johnfertitta/655/case/dxf/bottom.dxf

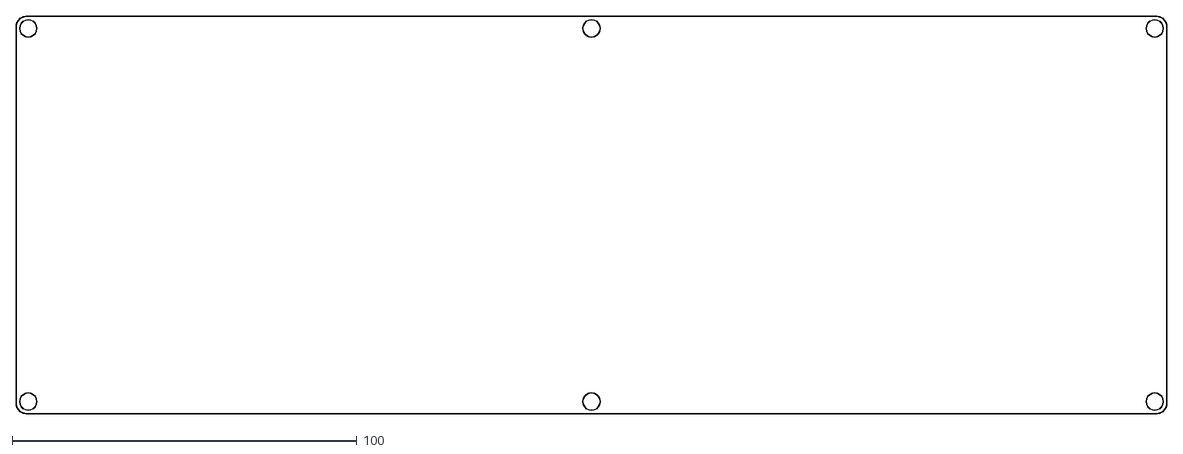
[picture p1: CAD file, 2016-08-23]
case/dxf/bottom.dxf
333.9 x 115.3
