johnfertitta/655/Test board/Plate files/plate.dxf

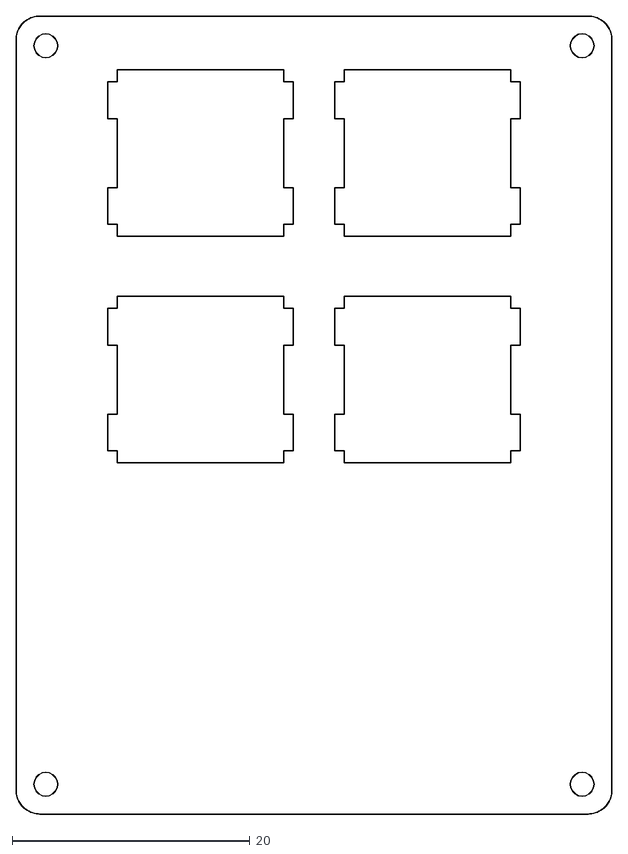
[picture p2: CAD file, 2016-08-31]
Test board/Plate files/plate.dxf
50.1 x 67.1
