johnfertitta/655/case/dxf/closed.dxf

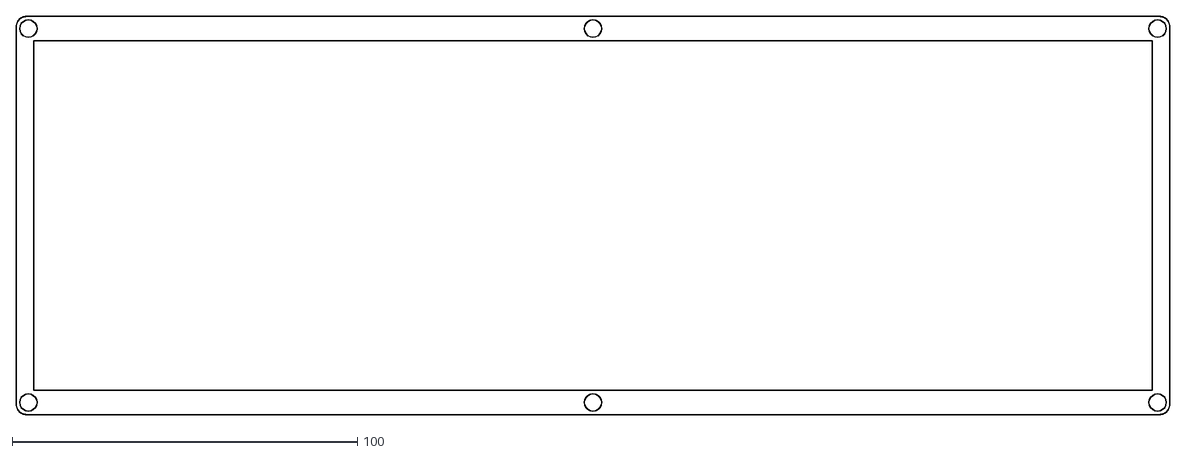
[picture p3: CAD file, 2016-08-23]
case/dxf/closed.dxf
333.9 x 115.3
