johnfertitta/655/Test board/Plate files/layout_guide.dxf

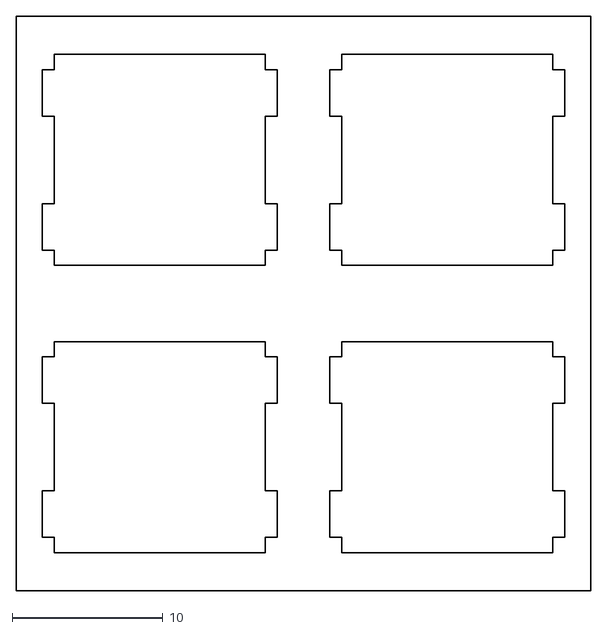
[picture p4: CAD file, 2016-08-31]
Test board/Plate files/layout_guide.dxf
38.1 x 38.1
