johnfertitta/655/case/dxf/switch.dxf

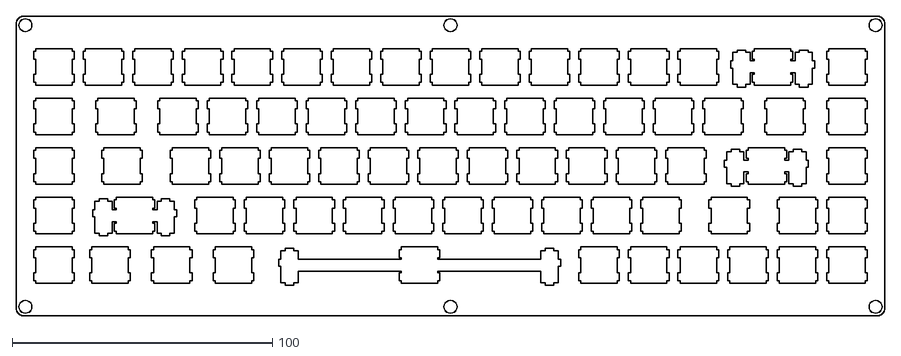
[picture p5: CAD file, 2016-08-23]
case/dxf/switch.dxf
333.9 x 115.3
