johnfertitta/655/case/dxf/open.dxf

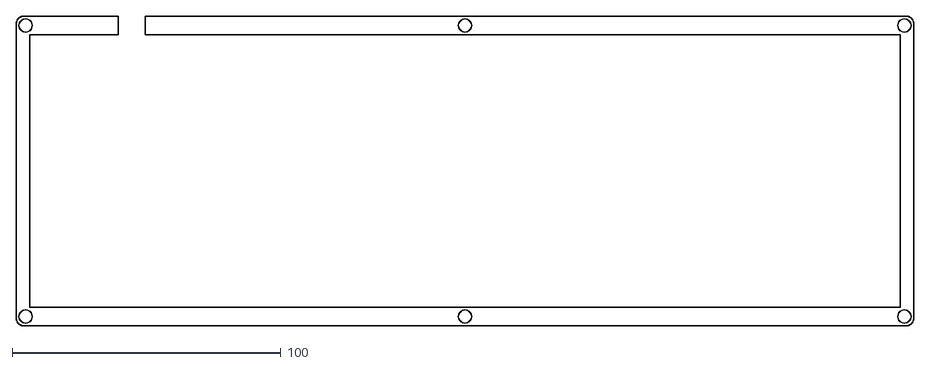
[picture p6: CAD file, 2016-08-23]
case/dxf/open.dxf
333.9 x 115.3
