johnfertitta/655/Test board/gerber-pdf/testboard-B.Mask.pdf

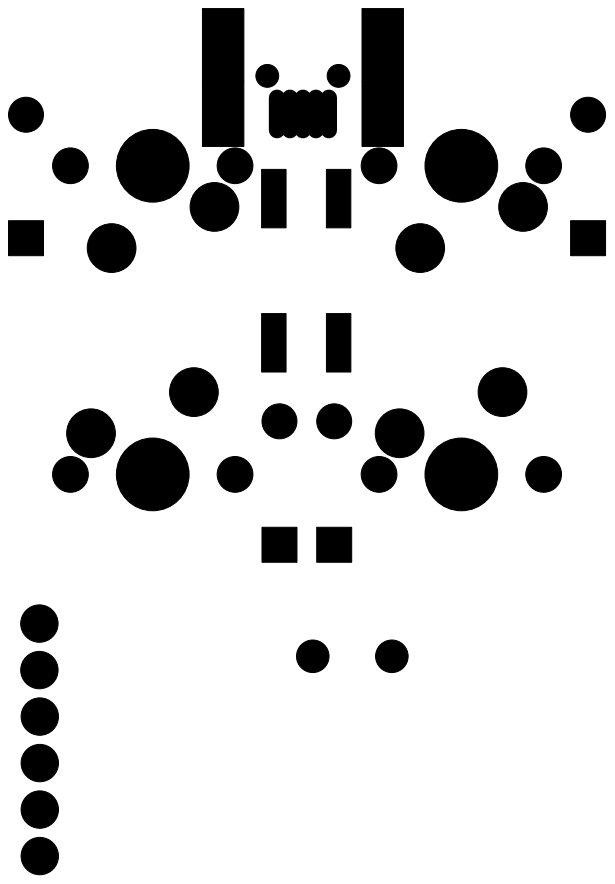
[picture p7: page 1]
