johnfertitta/655/Test board/gerber-pdf/testboard-B.SilkS.pdf

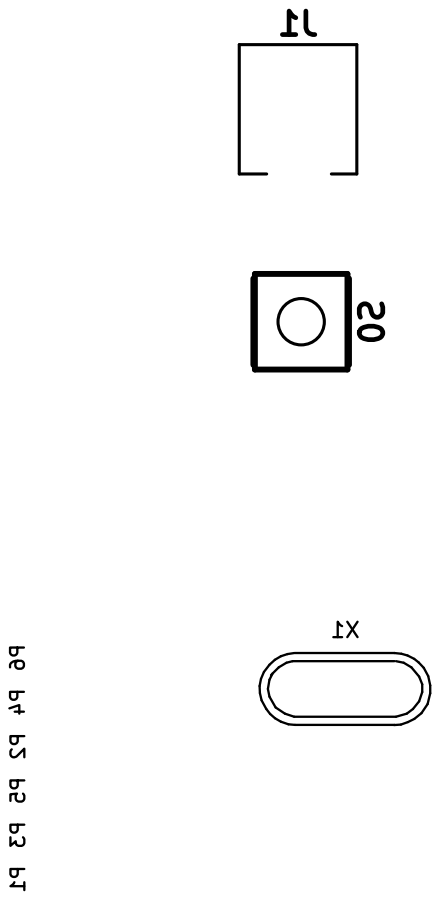
[picture p8: page 1]
