johnfertitta/655/Test board/gerber-pdf/testboard-Back.pdf

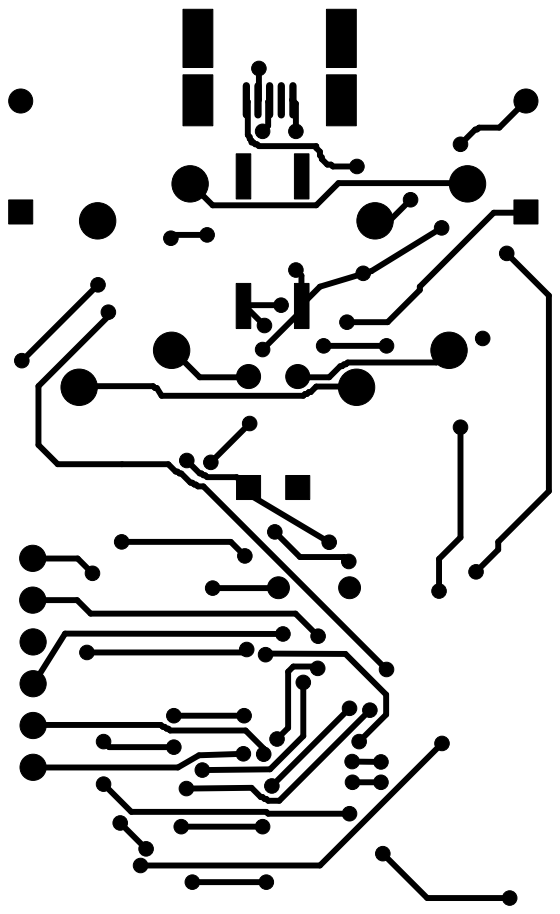
[picture p9: page 1]
