johnfertitta/655/Test board/gerber-pdf/testboard-Eco2.User.pdf

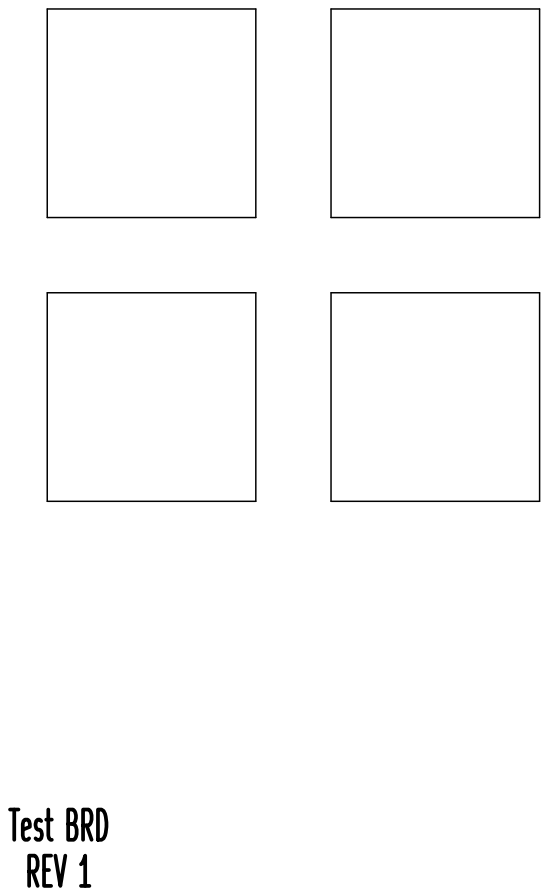
[picture p10: page 1]
