johnfertitta/655/Test board/gerber-pdf/testboard-F.Mask.pdf

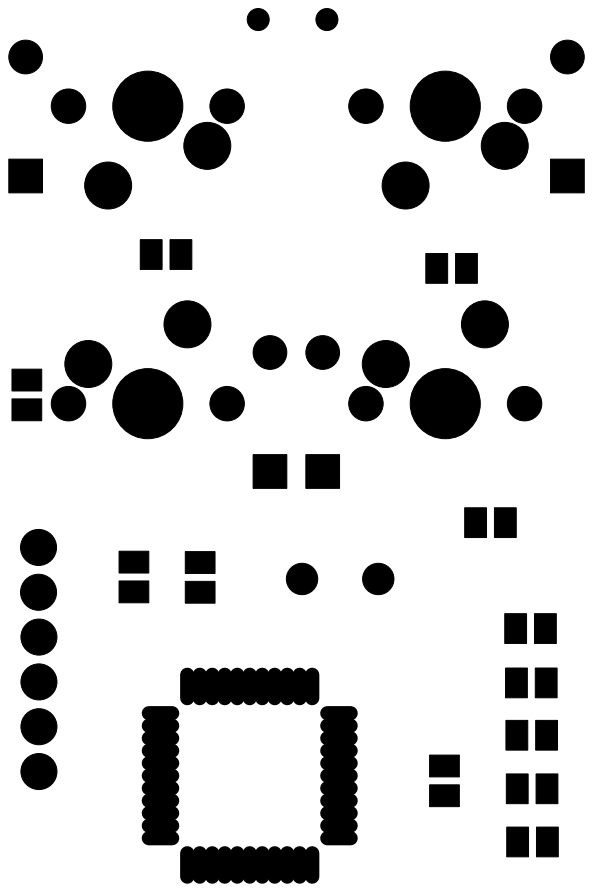
[picture p11: page 1]
