johnfertitta/655/Test board/gerber-pdf/testboard-F.SilkS.pdf

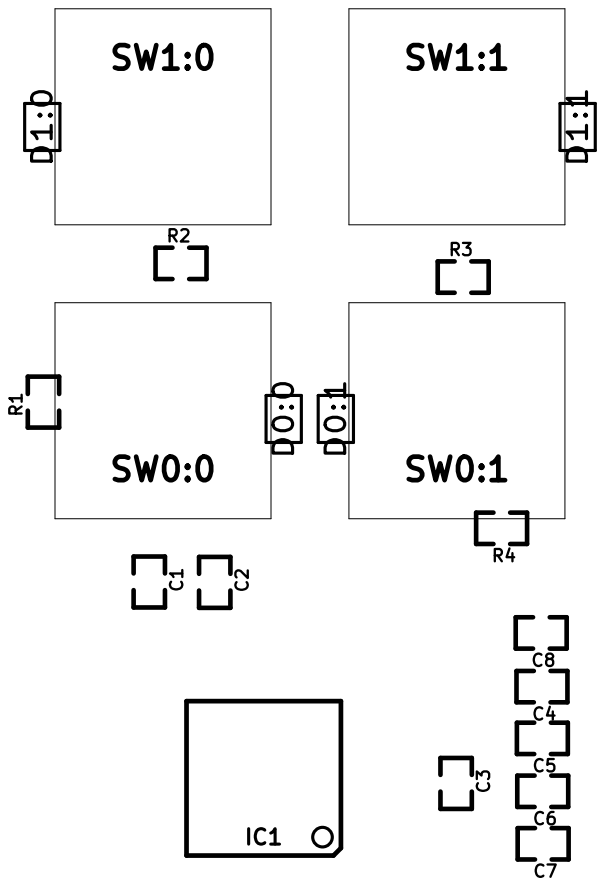
[picture p12: page 1]
