johnfertitta/655/Test board/gerber-pdf/testboard-Front.pdf

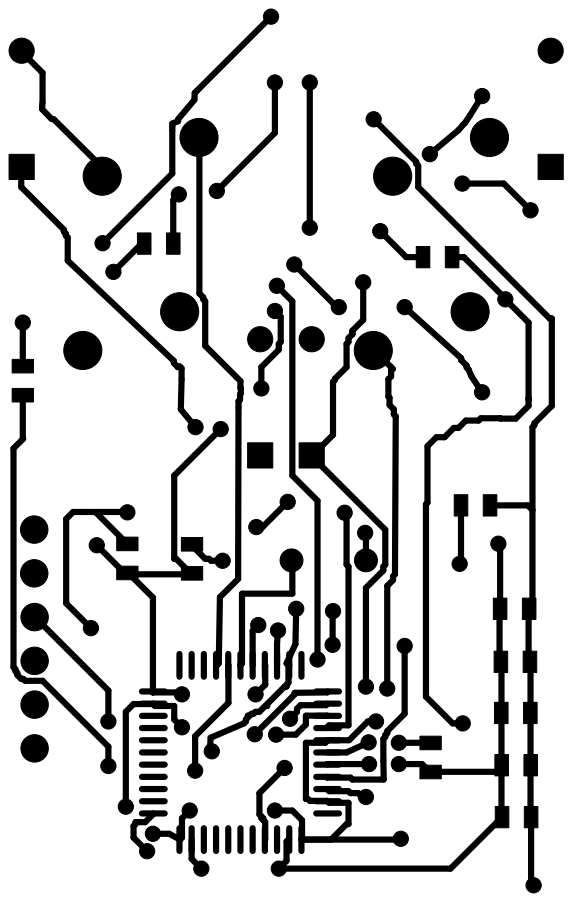
[picture p13: page 1]
