johnfertitta/655/655-Kicad/gerber-pdf/655-B.Mask.pdf

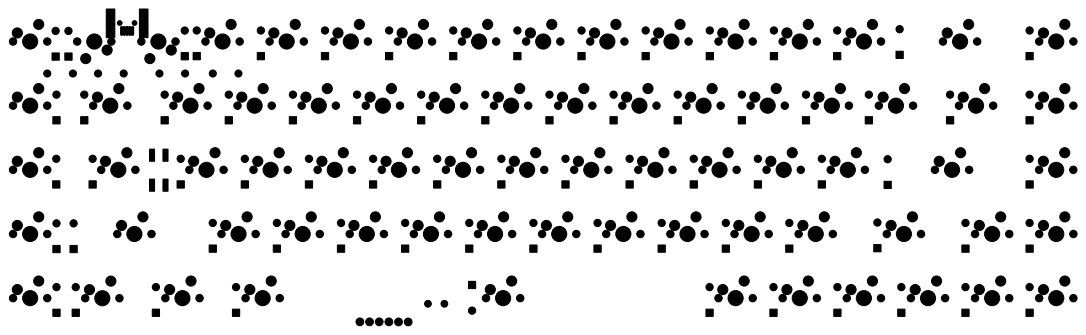
[picture p14: page 1]
