johnfertitta/655/655-Kicad/gerber-pdf/655-B.SilkS.pdf

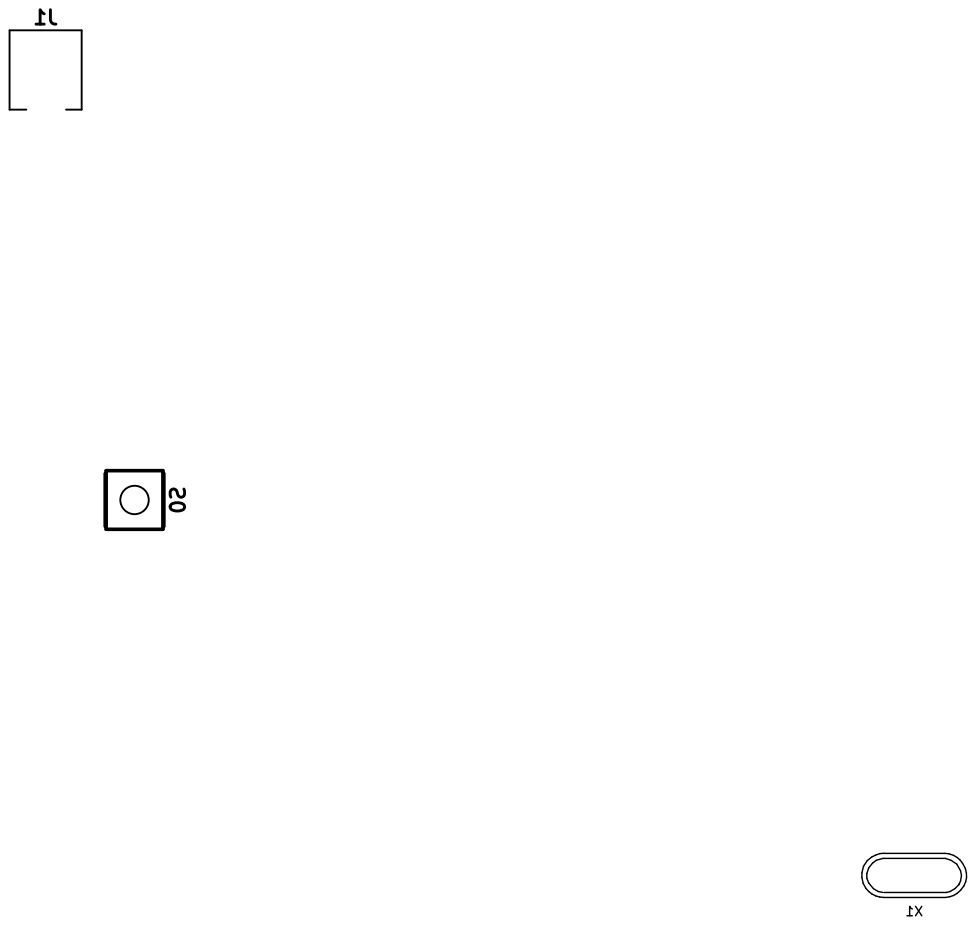
[picture p15: page 1]
