johnfertitta/655/655-Kicad/gerber-pdf/655-Back.pdf

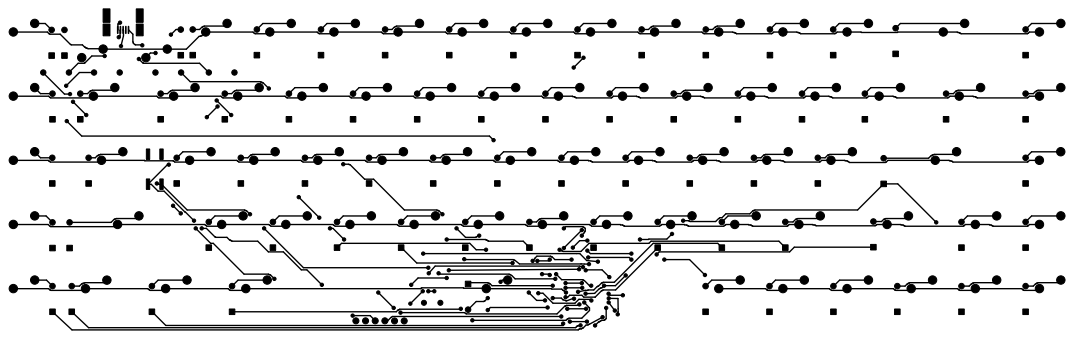
[picture p16: page 1]
