johnfertitta/655/655-Kicad/gerber-pdf/655-Eco2.User.pdf

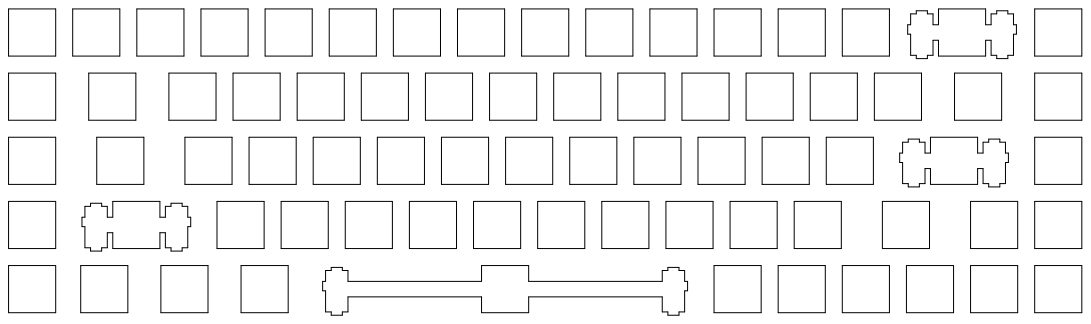
[picture p17: page 1]
