johnfertitta/655/655-Kicad/gerber-pdf/655-F.Mask.pdf

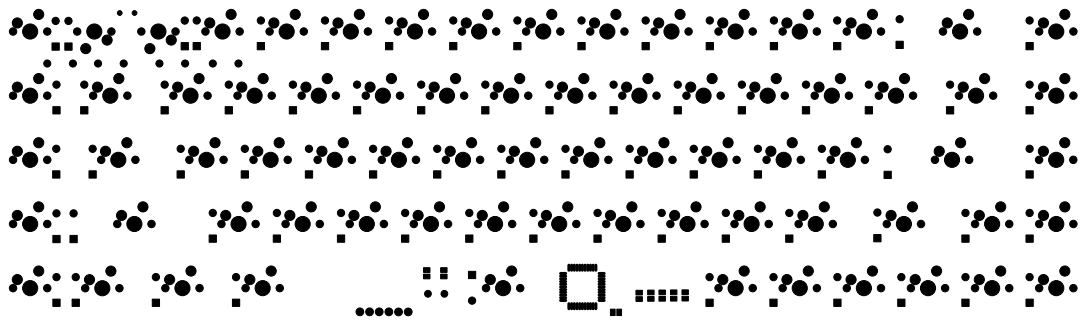
[picture p18: page 1]
