johnfertitta/655/655-Kicad/gerber-pdf/655-F.SilkS.pdf

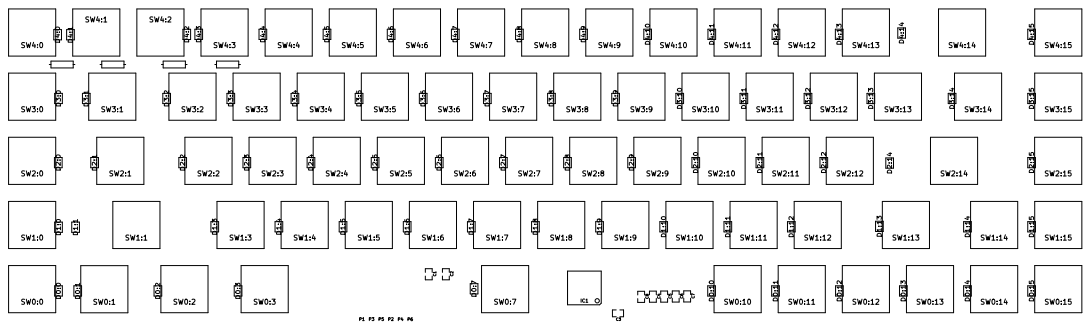
[picture p19: page 1]
