johnfertitta/655/655-Kicad/gerber-pdf/655-Front.pdf

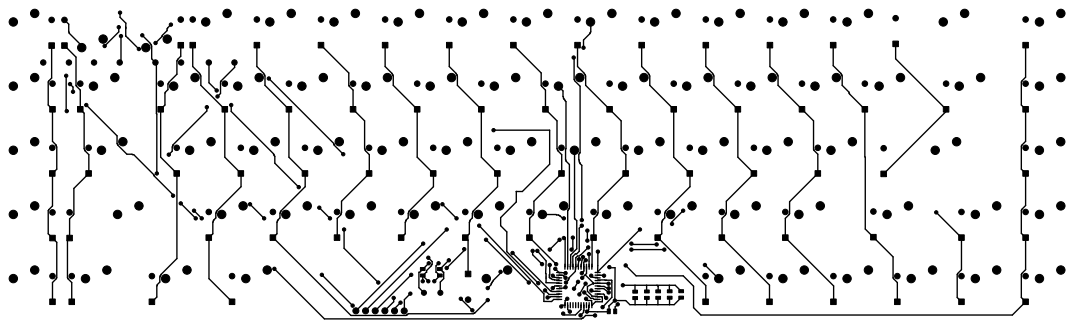
[picture p20: page 1]
