johnfertitta/655/Test board/testboard.kicad_pcb

## KiCad design Test board/testboard.kicad_pcb (2016-08-31)

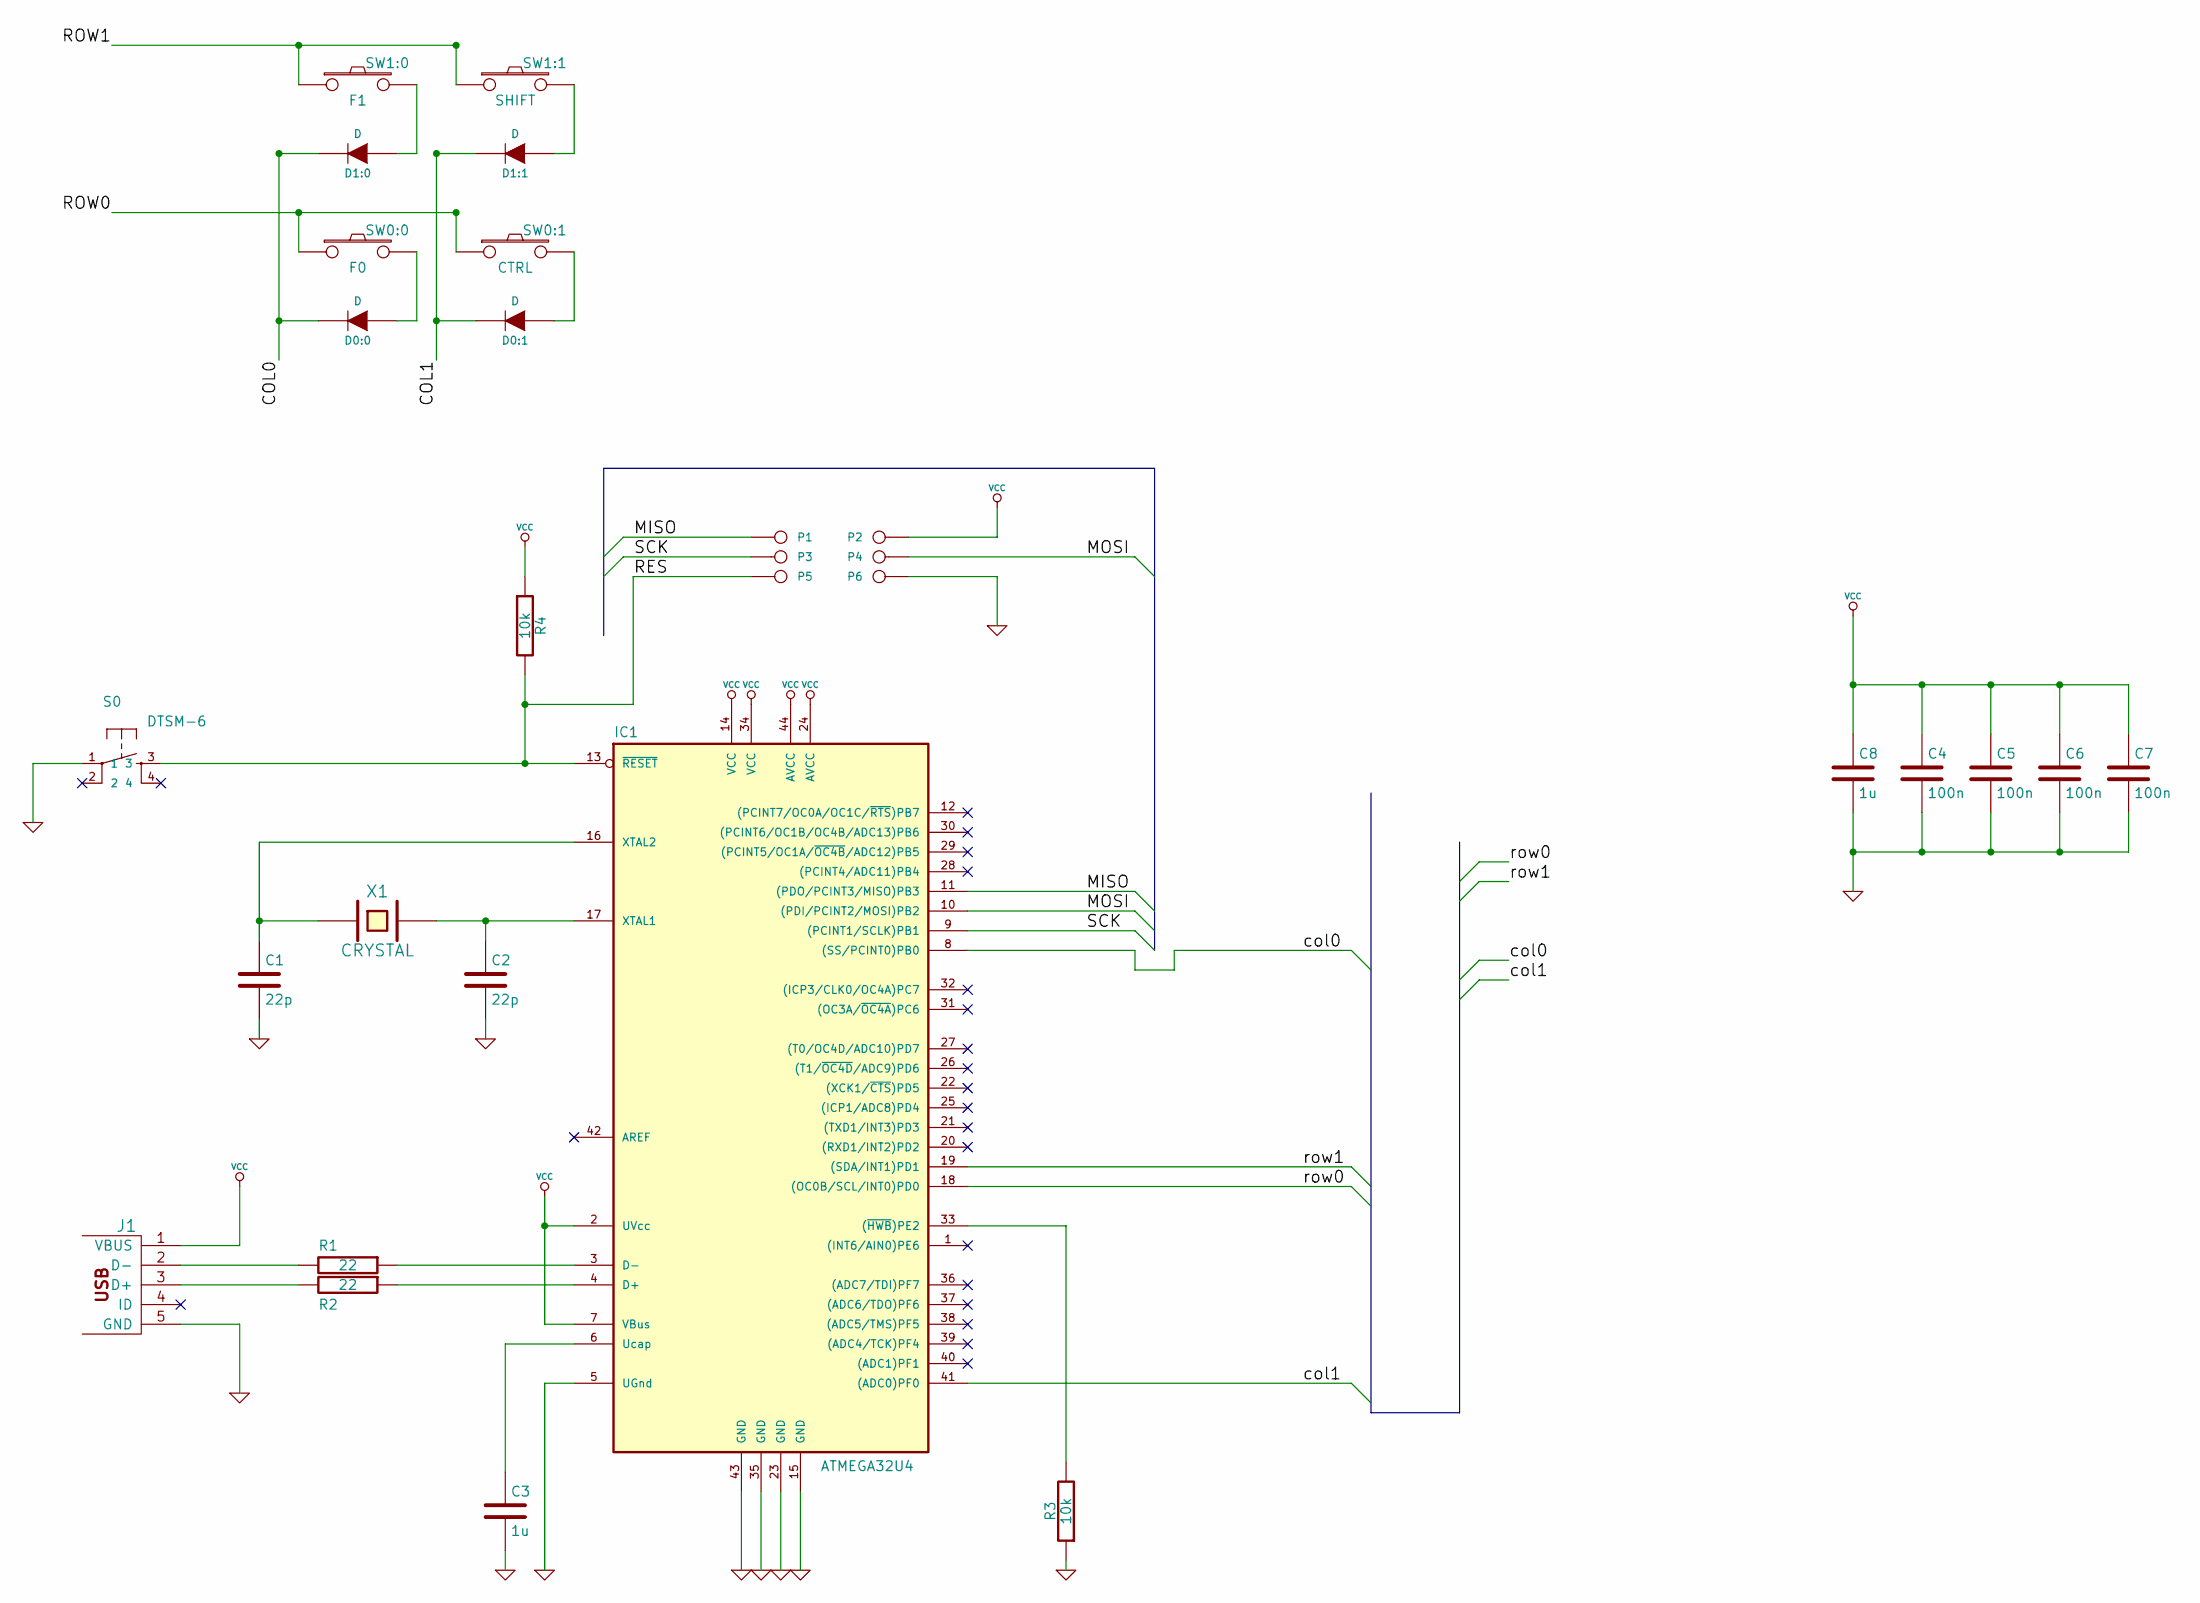
[picture p21: schematic testboard.sch]

Parts:
C1, C2: 22p; 0805C
C3, C8: 1u; 0805C
C4, C5, C6, C7: 100n; 0805C
D0:0, D0:1, D1:0, D1:1: D; DIODE
IC1: ATMEGA32U4; TQFP44
J1: USBMINI_B05; 67503
P1, P2, P3, P4, P5, P6: CONN_1; pad
R1, R2: 22; 0805R
R3, R4: 10k; 0805R
S0: DTSM-6; KSEM31GLFS
SW0:0: F0; MX1A
SW0:1: CTRL; MX1A
SW1:0: F1; MX1A
SW1:1: SHIFT; MX1A
X1: CRYSTAL; Crystal_HC49-U_Vertical

Connections:
/COL0: D0:0.2 (K), D1:0.2 (K), IC1.8 ((SS/PCINT0)PB0)
/COL1: D0:1.2 (K), D1:1.2 (K), IC1.41 ((ADC0)PF0)
/MISO: IC1.11 ((PDO/PCINT3/MISO)PB3), P1.1
/MOSI: IC1.10 ((PDI/PCINT2/MOSI)PB2), P4.1
/RES: IC1.13 (~RESET~), P5.1, R4.2, S0.3
/ROW0: IC1.18 ((OC0B/SCL/INT0)PD0), SW0:0.1, SW0:1.1
/ROW1: IC1.19 ((SDA/INT1)PD1), SW1:0.1, SW1:1.1
/SCK: IC1.9 ((PCINT1/SCLK)PB1), P3.1
GND: C1.2, C2.2, C3.2, C4.2, C5.2, C6.2, C7.2, C8.2, IC1.5 (UGnd), IC1.15 (GND), IC1.23 (GND), IC1.35 (GND), IC1.43 (GND), J1.5 (GND), P6.1, R3.1, S0.1
unnamed: C1.1, IC1.16 (XTAL2), X1.1
unnamed: C2.1, IC1.17 (XTAL1), X1.2
unnamed: C3.1, IC1.6 (Ucap)
unnamed: D0:0.1 (A), SW0:0.2
unnamed: D0:1.1 (A), SW0:1.2
unnamed: D1:0.1 (A), SW1:0.2
unnamed: D1:1.1 (A), SW1:1.2
unnamed: IC1.3 (D-), R1.1
unnamed: IC1.4 (D+), R2.1
unnamed: IC1.33 ((~HWB~)PE2), R3.2
unnamed: J1.2 (D-), R1.2
unnamed: J1.3 (D+), R2.2
VCC: C4.1, C5.1, C6.1, C7.1, C8.1, IC1.2 (UVcc), IC1.7 (VBus), IC1.14 (VCC), IC1.24 (AVCC), IC1.34 (VCC), IC1.44 (AVCC), J1.1 (VBUS), P2.1, R4.1

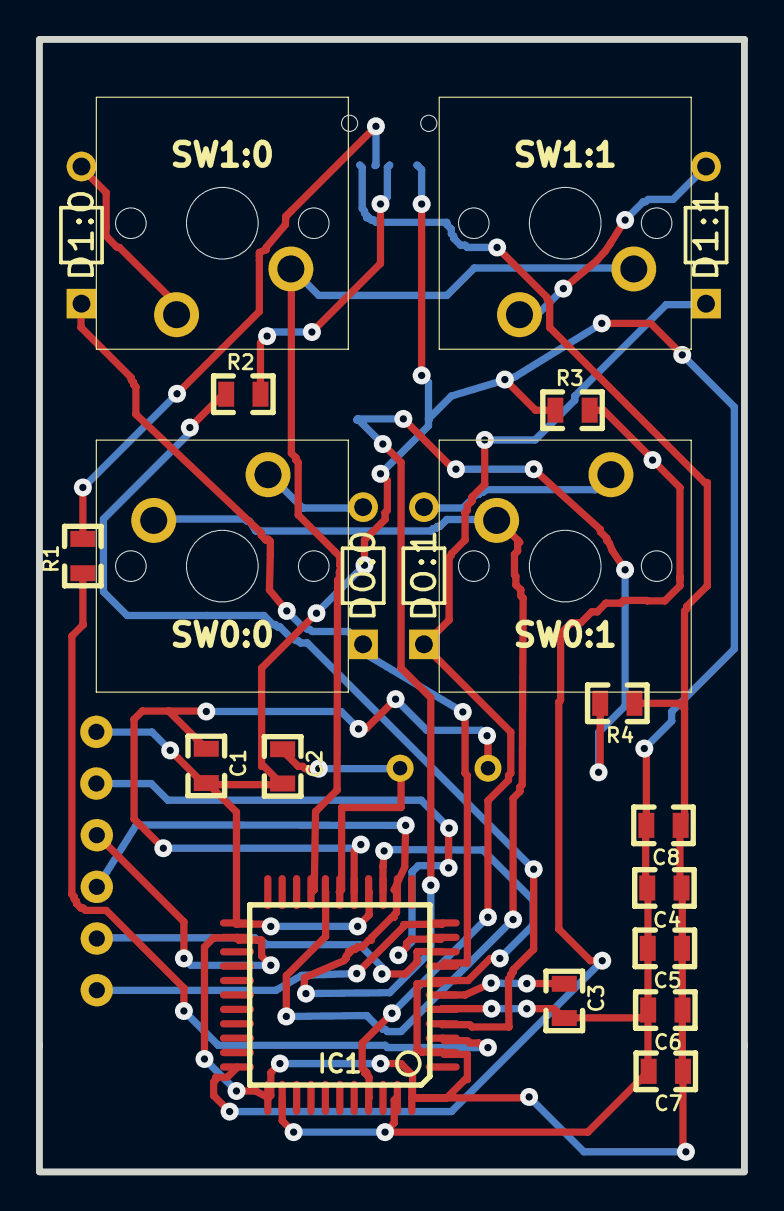
[picture p22: board testboard.kicad_pcb from above]

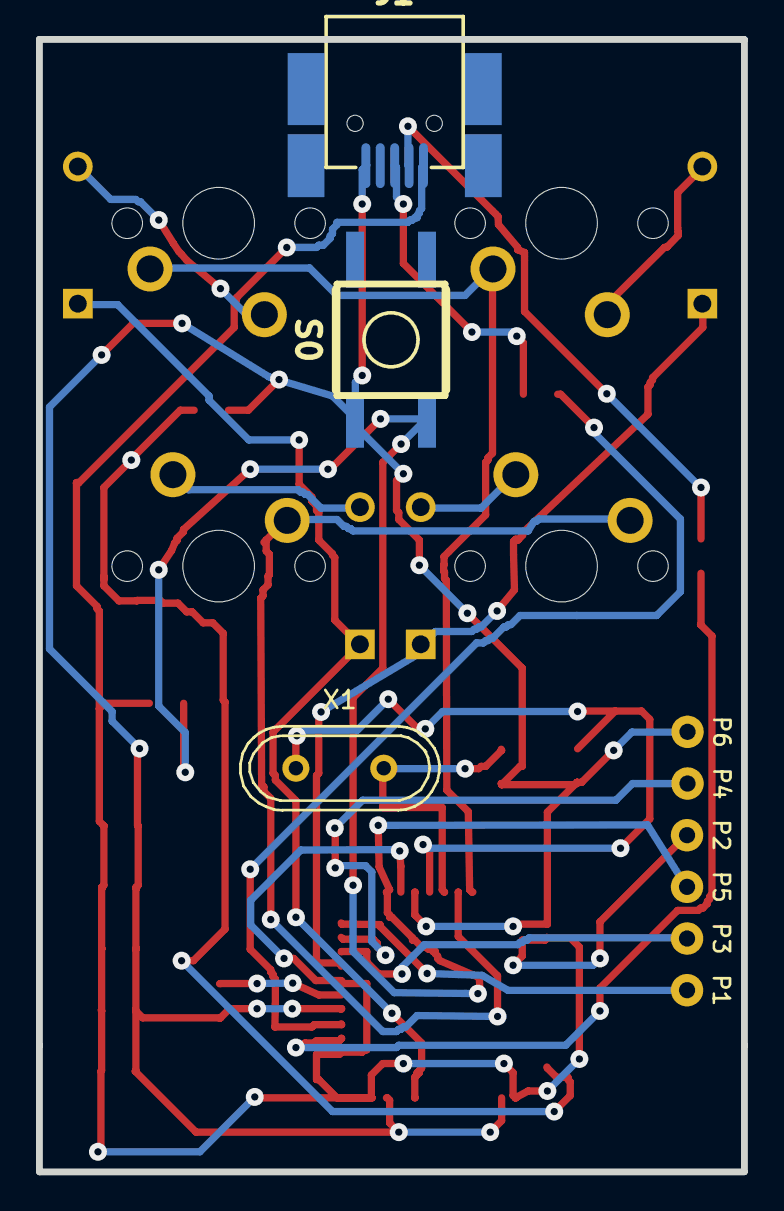
[picture p23: board testboard.kicad_pcb from below]

Board: 2 copper layers, 39.2 x 62.9 mm, 30 parts (9 on the bottom side), 22 nets.
