johnfertitta/655/655-Kicad/655.kicad_pcb

## KiCad design 655-Kicad/655.kicad_pcb (2016-08-31)

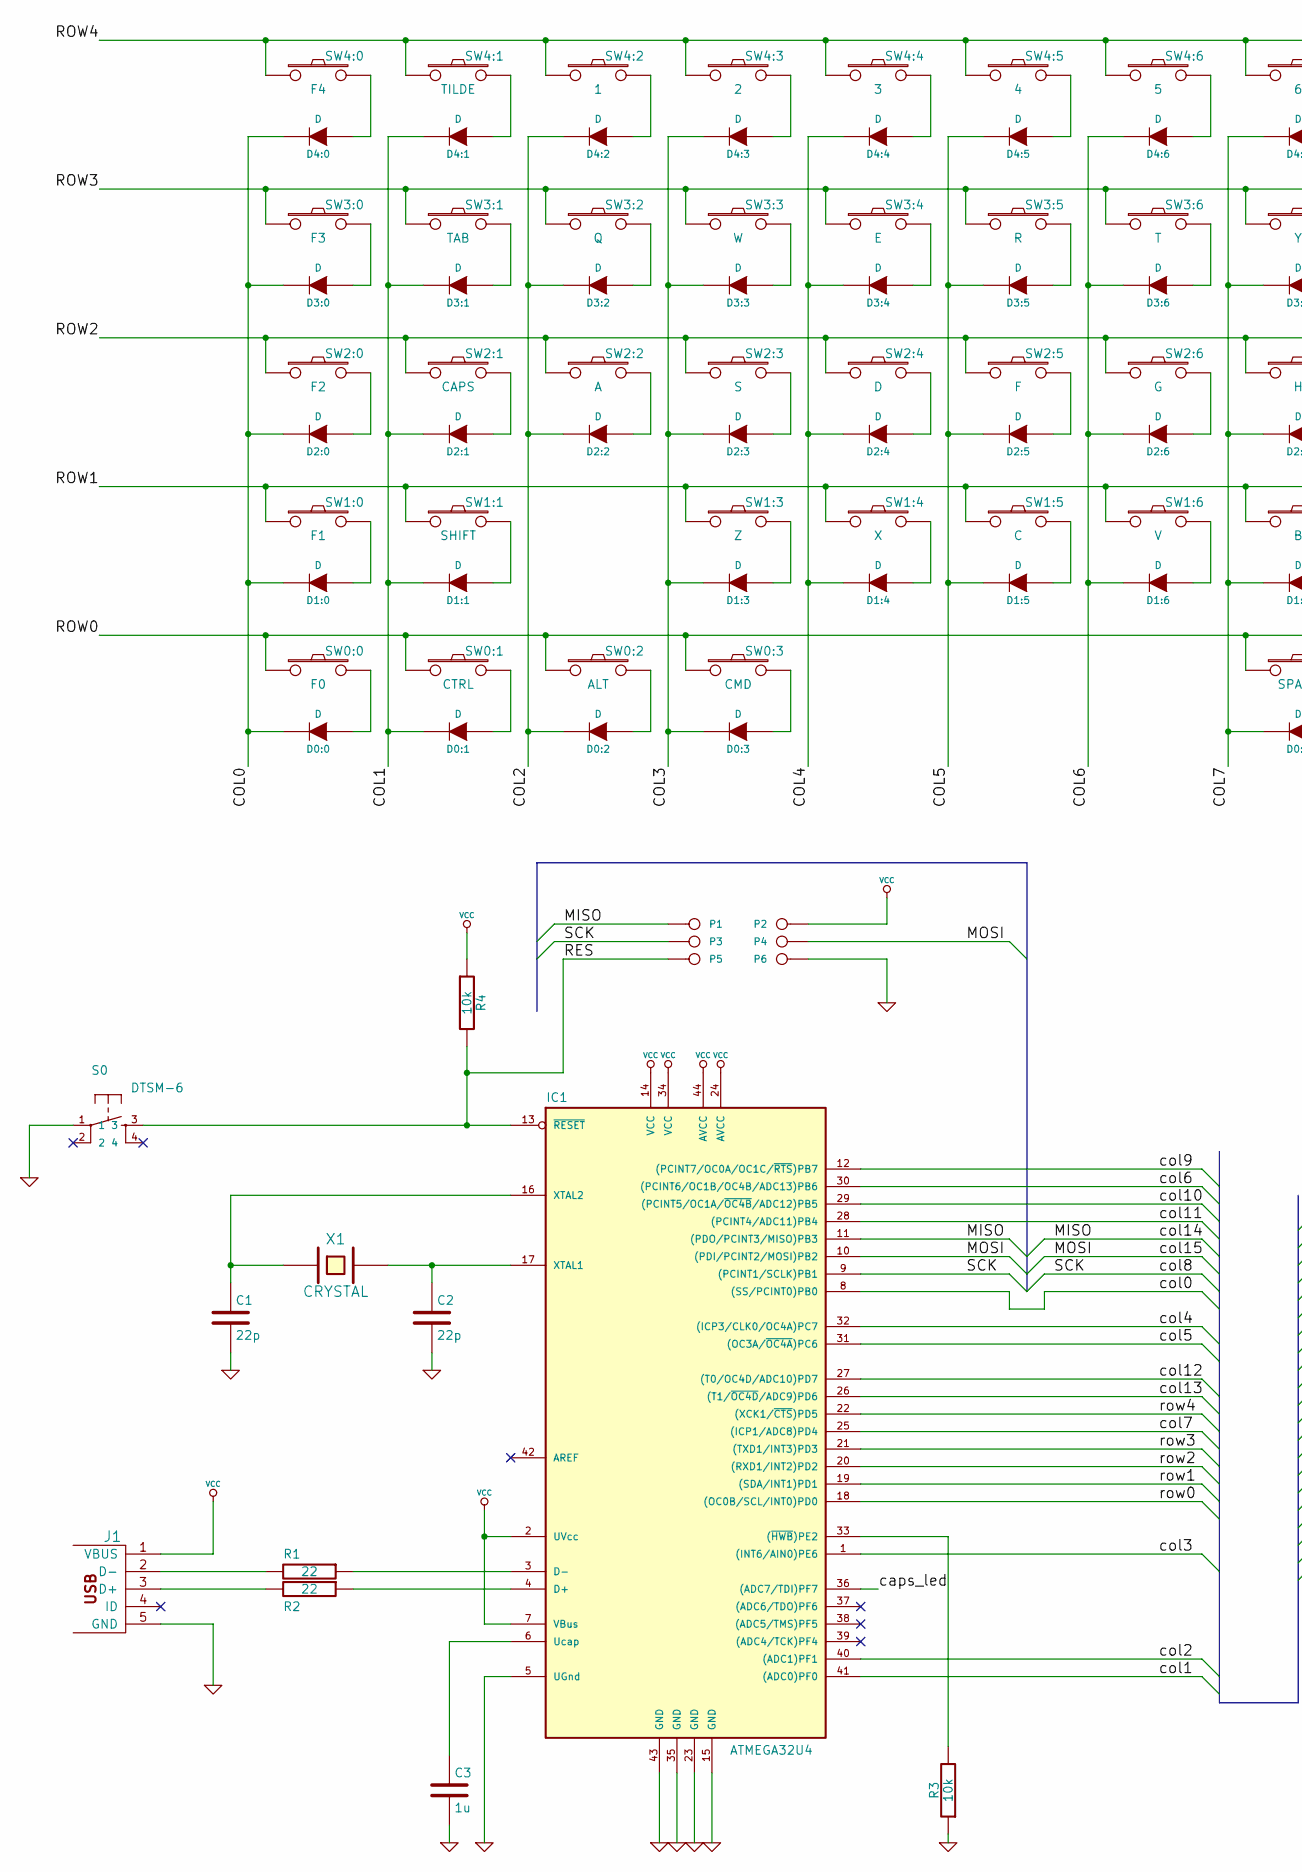
[picture p24: schematic 655.sch, part in row 1, column 1]

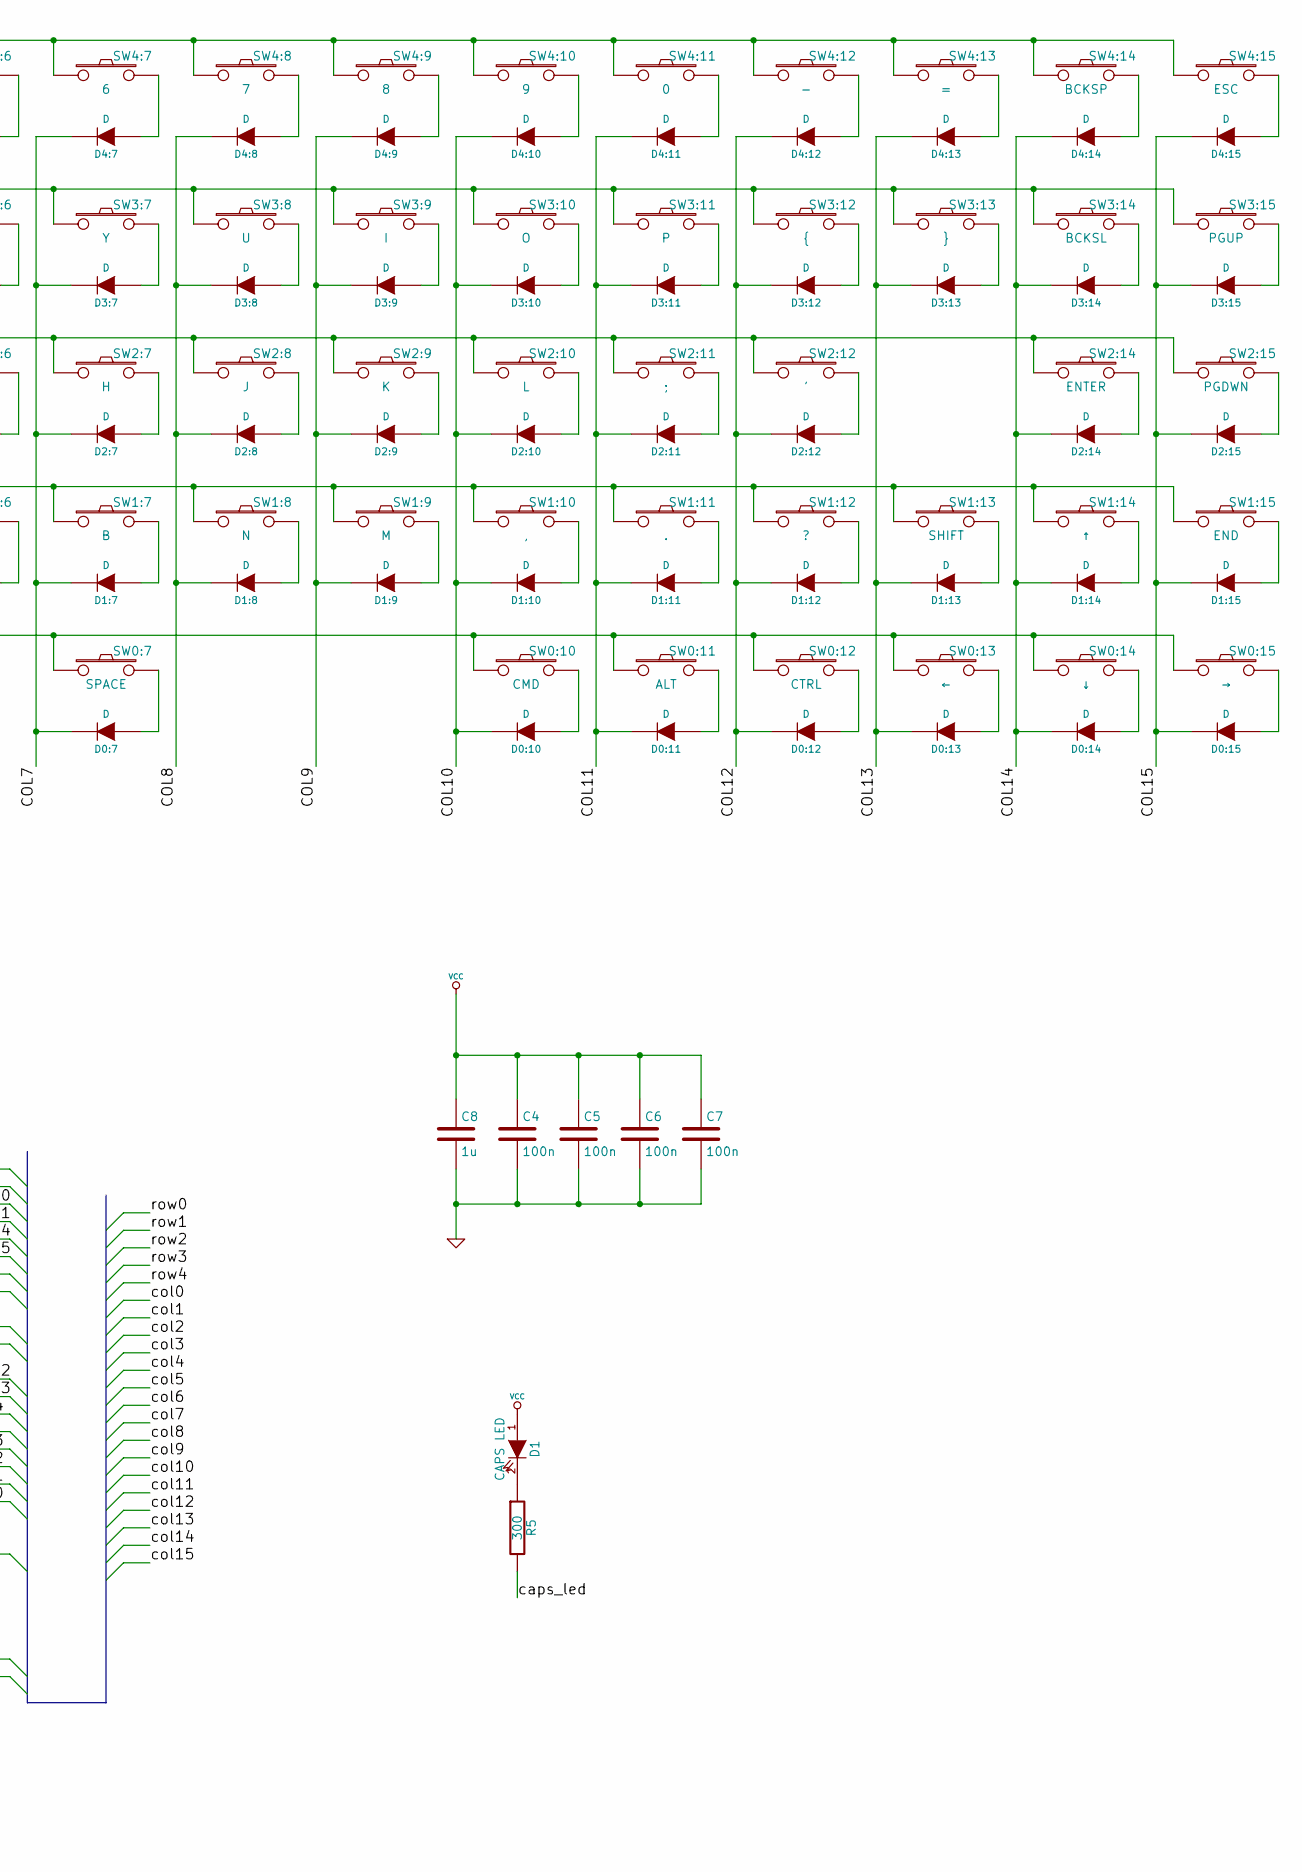
[picture p25: schematic 655.sch, part in row 1, column 2]

Parts:
C1, C2: 22p; 0805C
C3, C8: 1u; 0805C
C4, C5, C6, C7: 100n; 0805C
D0:0, D0:1, D0:2, D0:3, D0:7, D0:10, D0:11, D0:12, D0:13, D0:14, D0:15, D1:0, D1:1, D1:3, D1:4, D1:5, D1:6, D1:7, D1:8, D1:9, D1:10, D1:11, D1:12, D1:13, D1:14, D1:15, D2:0, D2:1, D2:2, D2:3, D2:4, D2:5, D2:6, D2:7, D2:8, D2:9, D2:10, D2:11, D2:12, D2:14, D2:15, D3:0, D3:1, D3:2, D3:3, D3:4, D3:5, D3:6, D3:7, D3:8, D3:9, D3:10, D3:11, D3:12, D3:13, D3:14, D3:15, D4:0, D4:1, D4:2, D4:3, D4:4, D4:5, D4:6, D4:7, D4:8, D4:9, D4:10, D4:11, D4:12, D4:13, D4:14, D4:15: D; DIODE
D1: CAPS LED; MX1A-led
IC1: ATMEGA32U4; TQFP44
J1: USBMINI_B05; 67503
P1, P2, P3, P4, P5, P6: CONN_1; pad
R1, R2: 22; 0805R
R3, R4: 10k; 0805R
R5: 300; 0805R
S0: DTSM-6; KSEM31GLFS
SW0:0: F0; MX1A
SW0:1, SW0:12: CTRL; MX1A
SW0:2, SW0:11: ALT; MX1A
SW0:3, SW0:10: CMD; MX1A
SW0:7: SPACE; MX1A
SW0:13: ←; MX1A
SW0:14: ↓; MX1A
SW0:15: →; MX1A
SW1:0: F1; MX1A
SW1:1, SW1:13: SHIFT; MX1A
SW1:3: Z; MX1A
SW1:4: X; MX1A
SW1:5: C; MX1A
SW1:6: V; MX1A
SW1:7: B; MX1A
SW1:8: N; MX1A
SW1:9: M; MX1A
SW1:10: ,; MX1A
SW1:11: .; MX1A
SW1:12: ?; MX1A
SW1:14: ↑; MX1A
SW1:15: END; MX1A
SW2:0: F2; MX1A
SW2:1: CAPS; MX1A
SW2:2: A; MX1A
SW2:3: S; MX1A
SW2:4: D; MX1A
SW2:5: F; MX1A
SW2:6: G; MX1A
SW2:7: H; MX1A
SW2:8: J; MX1A
SW2:9: K; MX1A
SW2:10: L; MX1A
SW2:11: ;; MX1A
SW2:12: '; MX1A
SW2:14: ENTER; MX1A
SW2:15: PGDWN; MX1A
SW3:0: F3; MX1A
SW3:1: TAB; MX1A
SW3:2: Q; MX1A
SW3:3: W; MX1A
SW3:4: E; MX1A
SW3:5: R; MX1A
SW3:6: T; MX1A
SW3:7: Y; MX1A
SW3:8: U; MX1A
SW3:9: I; MX1A
SW3:10: O; MX1A
SW3:11: P; MX1A
SW3:12: {; MX1A
SW3:13: }; MX1A
SW3:14: BCKSL; MX1A
SW3:15: PGUP; MX1A
SW4:0: F4; MX1A
SW4:1: TILDE; MX1A
SW4:2: 1; MX1A
SW4:3: 2; MX1A
SW4:4: 3; MX1A
SW4:5: 4; MX1A
SW4:6: 5; MX1A
SW4:7: 6; MX1A
SW4:8: 7; MX1A
SW4:9: 8; MX1A
SW4:10: 9; MX1A
SW4:11: 0; MX1A
SW4:12: -; MX1A
SW4:13: =; MX1A
SW4:14: BCKSP; MX1A
SW4:15: ESC; MX1A
X1: CRYSTAL; Crystal_HC49-U_Vertical

Connections:
/COL0: D0:0.2 (K), D1:0.2 (K), D2:0.2 (K), D3:0.2 (K), D4:0.2 (K), IC1.8 ((SS/PCINT0)PB0)
/COL1: D0:1.2 (K), D1:1.2 (K), D2:1.2 (K), D3:1.2 (K), D4:1.2 (K), IC1.41 ((ADC0)PF0)
/COL2: D0:2.2 (K), D2:2.2 (K), D3:2.2 (K), D4:2.2 (K), IC1.40 ((ADC1)PF1)
/COL3: D0:3.2 (K), D1:3.2 (K), D2:3.2 (K), D3:3.2 (K), D4:3.2 (K), IC1.1 ((INT6/AIN0)PE6)
/COL4: D1:4.2 (K), D2:4.2 (K), D3:4.2 (K), D4:4.2 (K), IC1.32 ((ICP3/CLK0/OC4A)PC7)
/COL5: D1:5.2 (K), D2:5.2 (K), D3:5.2 (K), D4:5.2 (K), IC1.31 ((OC3A/~OC4A~)PC6)
/COL6: D1:6.2 (K), D2:6.2 (K), D3:6.2 (K), D4:6.2 (K), IC1.30 ((PCINT6/OC1B/OC4B/ADC13)PB6)
/COL7: D0:7.2 (K), D1:7.2 (K), D2:7.2 (K), D3:7.2 (K), D4:7.2 (K), IC1.25 ((ICP1/ADC8)PD4)
/COL8: D1:8.2 (K), D2:8.2 (K), D3:8.2 (K), D4:8.2 (K), IC1.9 ((PCINT1/SCLK)PB1), P3.1
/COL9: D1:9.2 (K), D2:9.2 (K), D3:9.2 (K), D4:9.2 (K), IC1.12 ((PCINT7/OC0A/OC1C/~RTS~)PB7)
/COL10: D0:10.2 (K), D1:10.2 (K), D2:10.2 (K), D3:10.2 (K), D4:10.2 (K), IC1.29 ((PCINT5/OC1A/~OC4B~/ADC12)PB5)
/COL11: D0:11.2 (K), D1:11.2 (K), D2:11.2 (K), D3:11.2 (K), D4:11.2 (K), IC1.28 ((PCINT4/ADC11)PB4)
/COL12: D0:12.2 (K), D1:12.2 (K), D2:12.2 (K), D3:12.2 (K), D4:12.2 (K), IC1.27 ((T0/OC4D/ADC10)PD7)
/COL13: D0:13.2 (K), D1:13.2 (K), D3:13.2 (K), D4:13.2 (K), IC1.26 ((T1/~OC4D~/ADC9)PD6)
/COL14: D0:14.2 (K), D1:14.2 (K), D2:14.2 (K), D3:14.2 (K), D4:14.2 (K), IC1.11 ((PDO/PCINT3/MISO)PB3), P1.1
/COL15: D0:15.2 (K), D1:15.2 (K), D2:15.2 (K), D3:15.2 (K), D4:15.2 (K), IC1.10 ((PDI/PCINT2/MOSI)PB2), P4.1
/RES: IC1.13 (~RESET~), P5.1, R4.2, S0.3
/ROW0: IC1.18 ((OC0B/SCL/INT0)PD0), SW0:0.1, SW0:1.1, SW0:2.1, SW0:3.1, SW0:7.1, SW0:10.1, SW0:11.1, SW0:12.1, SW0:13.1, SW0:14.1, SW0:15.1
/ROW1: IC1.19 ((SDA/INT1)PD1), SW1:0.1, SW1:1.1, SW1:3.1, SW1:4.1, SW1:5.1, SW1:6.1, SW1:7.1, SW1:8.1, SW1:9.1, SW1:10.1, SW1:11.1, SW1:12.1, SW1:13.1, SW1:14.1, SW1:15.1
/ROW2: IC1.20 ((RXD1/INT2)PD2), SW2:0.1, SW2:1.1, SW2:2.1, SW2:3.1, SW2:4.1, SW2:5.1, SW2:6.1, SW2:7.1, SW2:8.1, SW2:9.1, SW2:10.1, SW2:11.1, SW2:12.1, SW2:14.1, SW2:15.1
/ROW3: IC1.21 ((TXD1/INT3)PD3), SW3:0.1, SW3:1.1, SW3:2.1, SW3:3.1, SW3:4.1, SW3:5.1, SW3:6.1, SW3:7.1, SW3:8.1, SW3:9.1, SW3:10.1, SW3:11.1, SW3:12.1, SW3:13.1, SW3:14.1, SW3:15.1
/ROW4: IC1.22 ((XCK1/~CTS~)PD5), SW4:0.1, SW4:1.1, SW4:2.1, SW4:3.1, SW4:4.1, SW4:5.1, SW4:6.1, SW4:7.1, SW4:8.1, SW4:9.1, SW4:10.1, SW4:11.1, SW4:12.1, SW4:13.1, SW4:14.1, SW4:15.1
/caps_led: IC1.36 ((ADC7/TDI)PF7), R5.2
GND: C1.2, C2.2, C3.2, C4.2, C5.2, C6.2, C7.2, C8.2, IC1.5 (UGnd), IC1.15 (GND), IC1.23 (GND), IC1.35 (GND), IC1.43 (GND), J1.5 (GND), P6.1, R3.1, S0.1
unnamed: C1.1, IC1.16 (XTAL2), X1.1
unnamed: C2.1, IC1.17 (XTAL1), X1.2
unnamed: C3.1, IC1.6 (Ucap)
unnamed: D0:0.1 (A), SW0:0.2
unnamed: D0:1.1 (A), SW0:1.2
unnamed: D0:2.1 (A), SW0:2.2
unnamed: D0:3.1 (A), SW0:3.2
unnamed: D0:7.1 (A), SW0:7.2
unnamed: D0:10.1 (A), SW0:10.2
unnamed: D0:11.1 (A), SW0:11.2
unnamed: D0:12.1 (A), SW0:12.2
unnamed: D0:13.1 (A), SW0:13.2
unnamed: D0:14.1 (A), SW0:14.2
unnamed: D0:15.1 (A), SW0:15.2
unnamed: D1.2 (K), R5.1
unnamed: D1:0.1 (A), SW1:0.2
unnamed: D1:1.1 (A), SW1:1.2
unnamed: D1:3.1 (A), SW1:3.2
unnamed: D1:4.1 (A), SW1:4.2
unnamed: D1:5.1 (A), SW1:5.2
unnamed: D1:6.1 (A), SW1:6.2
unnamed: D1:7.1 (A), SW1:7.2
unnamed: D1:8.1 (A), SW1:8.2
unnamed: D1:9.1 (A), SW1:9.2
unnamed: D1:10.1 (A), SW1:10.2
unnamed: D1:11.1 (A), SW1:11.2
unnamed: D1:12.1 (A), SW1:12.2
unnamed: D1:13.1 (A), SW1:13.2
unnamed: D1:14.1 (A), SW1:14.2
unnamed: D1:15.1 (A), SW1:15.2
unnamed: D2:0.1 (A), SW2:0.2
unnamed: D2:1.1 (A), SW2:1.2
unnamed: D2:2.1 (A), SW2:2.2
unnamed: D2:3.1 (A), SW2:3.2
unnamed: D2:4.1 (A), SW2:4.2
unnamed: D2:5.1 (A), SW2:5.2
unnamed: D2:6.1 (A), SW2:6.2
unnamed: D2:7.1 (A), SW2:7.2
unnamed: D2:8.1 (A), SW2:8.2
unnamed: D2:9.1 (A), SW2:9.2
unnamed: D2:10.1 (A), SW2:10.2
unnamed: D2:11.1 (A), SW2:11.2
unnamed: D2:12.1 (A), SW2:12.2
unnamed: D2:14.1 (A), SW2:14.2
unnamed: D2:15.1 (A), SW2:15.2
unnamed: D3:0.1 (A), SW3:0.2
unnamed: D3:1.1 (A), SW3:1.2
unnamed: D3:2.1 (A), SW3:2.2
unnamed: D3:3.1 (A), SW3:3.2
unnamed: D3:4.1 (A), SW3:4.2
unnamed: D3:5.1 (A), SW3:5.2
unnamed: D3:6.1 (A), SW3:6.2
unnamed: D3:7.1 (A), SW3:7.2
unnamed: D3:8.1 (A), SW3:8.2
unnamed: D3:9.1 (A), SW3:9.2
unnamed: D3:10.1 (A), SW3:10.2
unnamed: D3:11.1 (A), SW3:11.2
unnamed: D3:12.1 (A), SW3:12.2
unnamed: D3:13.1 (A), SW3:13.2
unnamed: D3:14.1 (A), SW3:14.2
unnamed: D3:15.1 (A), SW3:15.2
unnamed: D4:0.1 (A), SW4:0.2
unnamed: D4:1.1 (A), SW4:1.2
unnamed: D4:2.1 (A), SW4:2.2
unnamed: D4:3.1 (A), SW4:3.2
unnamed: D4:4.1 (A), SW4:4.2
unnamed: D4:5.1 (A), SW4:5.2
unnamed: D4:6.1 (A), SW4:6.2
unnamed: D4:7.1 (A), SW4:7.2
unnamed: D4:8.1 (A), SW4:8.2
unnamed: D4:9.1 (A), SW4:9.2
unnamed: D4:10.1 (A), SW4:10.2
unnamed: D4:11.1 (A), SW4:11.2
unnamed: D4:12.1 (A), SW4:12.2
unnamed: D4:13.1 (A), SW4:13.2
unnamed: D4:14.1 (A), SW4:14.2
unnamed: D4:15.1 (A), SW4:15.2
unnamed: IC1.3 (D-), R1.1
unnamed: IC1.4 (D+), R2.1
unnamed: IC1.33 ((~HWB~)PE2), R3.2
unnamed: J1.2 (D-), R1.2
unnamed: J1.3 (D+), R2.2
VCC: C4.1, C5.1, C6.1, C7.1, C8.1, D1.1 (A), IC1.2 (UVcc), IC1.7 (VBus), IC1.14 (VCC), IC1.24 (AVCC), IC1.34 (VCC), IC1.44 (AVCC), J1.1 (VBUS), P2.1, R4.1

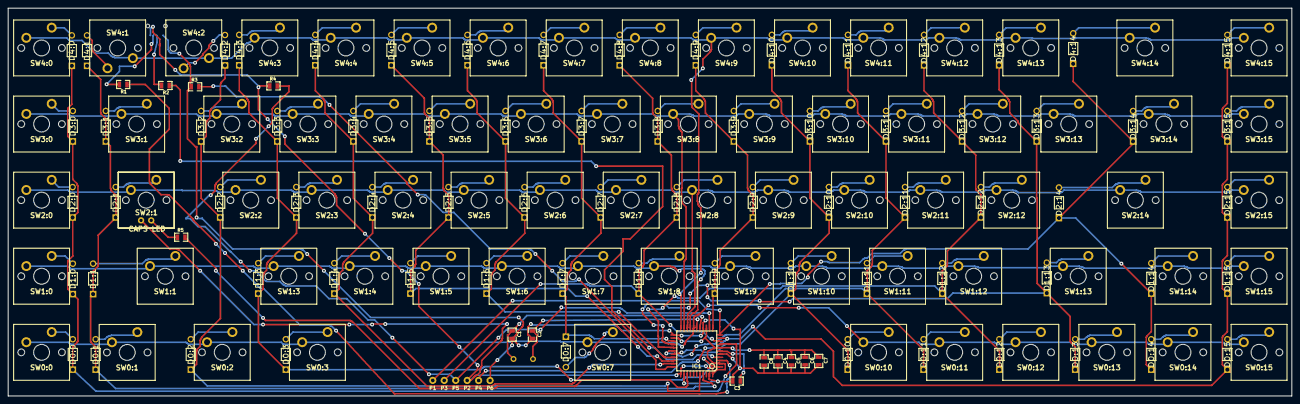
[picture p26: board 655.kicad_pcb from above]

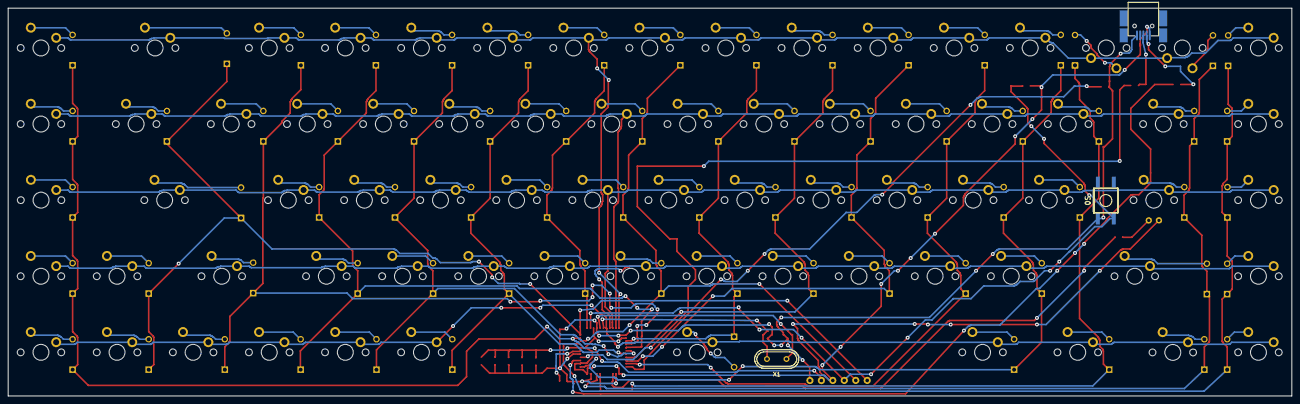
[picture p27: board 655.kicad_pcb from below]

Board: 2 copper layers, 321.4 x 97.1 mm, 170 parts (3 on the bottom side), 107 nets.
