johnfertitta/655/firmware/keymap_common.h

/*
Copyright 2012,2013 Jun Wako <wakojun@gmail.com>

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
You should have received a copy of the GNU General Public License
along with this program.  If not, see <http://www.gnu.org/licenses/>.
*/
#ifndef KEYMAP_COMMON_H
#define KEYMAP_COMMON_H

#include <stdint.h>
#include <stdbool.h>
#include "keycode.h"
#include "action.h"
#include "action_macro.h"
#include "report.h"
#include "host.h"
#include "print.h"
#include "debug.h"
#include "keymap.h"


/* 655 keymap definition macro
 */
#define KEYMAP( \
    K40, K41, K42, K43, K44, K45, K46, K47, K48, K49, K4A, K4B, K4C, K4D, K4E, K4F, \
    K30, K31, K32, K33, K34, K35, K36, K37, K38, K39, K3A, K3B, K3C, K3D, K3E, K3F, \
    K20, K21, K22, K23, K24, K25, K26, K27, K28, K29, K2A, K2B,      K2D, K2E, K2F, \
    K10, K11,      K13, K14, K15, K16, K17, K18, K19, K1A, K1B, K1C, K1D, K1E, K1F, \
    K00, K01, K02, K03,                K07,           K0A, K0B, K0C, K0D  K0E, K0F\
) { \
    { KC_##K40, KC_##K41, KC_##K42, KC_##K43, KC_##K44, KC_##K45, KC_##K46, KC_##K47, KC_##K48, KC_##K49, KC_##K4A, KC_##K4B, KC_##K4C, KC_##K4D, KC_##K4E, KC_##KF }, \
    { KC_##K30, KC_##K31, KC_##K32, KC_##K33, KC_##K34, KC_##K35, KC_##K36, KC_##K37, KC_##K38, KC_##K39, KC_##K3A, KC_##K3B, KC_##K3C, KC_##K3D, KC_##K3E, KC_##K3F }, \
    { KC_##K20, KC_##K21, KC_##K22, KC_##K23, KC_##K24, KC_##K25, KC_##K26, KC_##K27, KC_##K28, KC_##K29, KC_##K2A, KC_##K2B, KC_NO,    KC_##K2D, KC_##K2E, KC_##K2F }, \
    { KC_##K10, KC_##K11, KC_NO,    KC_##K13, KC_##K14, KC_##K25, KC_##K16, KC_##K17, KC_##K18, KC_##K19, KC_##K1A, KC_##K1B, KC_##K1C, KC_##K1D, KC_##K2E, KC_##K2F }, \
    { KC_##K00, KC_##K01, KC_##K02, KC_##K03, KC_NO,    KC_NO,    KC_NO,    KC_##K07, KC_NO,    KC_NO,    KC_##K0A, KC_##K0B, KC_##K0C, KC_##K0D, KC_##K0E, KC_##K0F }  \
}

#endif
