johnfertitta/655/(commit log)

2016-08-23 Kicad project, layout json, case drawings
    [655.csv, 655.kicad_pcb, 655.sch, bottom.dxf, closed.dxf, open.dxf, switch.dxf]
2016-08-23 update edge cuts to fit in the case
    [655.kicad_pcb]
2016-08-23 I think I made gerber files?
    [655-B.Mask.gbs, 655-B.SilkS.gbo, 655-Back.gbl, 655-Eco2.User.gbr, 655-Edge.Cuts.gm1, 655-F.Mask.gts, 655-F.SilkS.gto, 655-Front.gtl]
2016-08-23 test board
    [655.kicad_pcb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]
2016-08-23 Test board and full board BOM files
    [655.csv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]
2016-08-24 thinner cut line, moved in cut line, pdf printing files
    [655-B.Mask.gbs, 655-B.SilkS.gbo, 655-Back.gbl, 655-Eco2.User.gbr, 655-Edge.Cuts.gm1, 655-F.Mask.gts, 655-F.SilkS.gto, 655-Front.gtl]
2016-08-31 change resistor footprints to 0805R, add caps led
    [655.kicad_pcb, 655.sch, testboard.kicad_pcb, testboard.sch]
2016-08-31 new gerber files
    [testboard-B.Mask.gbr, testboard-B.SilkS.gbr, testboard-Back.gbr, testboard-Eco2.User.gbr, testboard-Edge.Cuts.gbr, testboard-F.Mask.gbr, testboard-F.SilkS.gbr, testboard-Front.gbr]
2016-08-31 bon update
    [655.csv]
